westondunn/elegoo-smart-car-v4/hardware/3d-models/rover-v3/verification/component_catalog.csv

part_id | name | quantity | category | material_intent | geometry_fidelity | step_file | notes
base | Full lower chassis | 1 | printed_part | PLA | Exact generated printable CAD. Full assembly has not been physically tested. | assets/printed/base.step | Exact C3 local motor interfaces; actual OEM front/rear spacing; widened230mm body; four strap slots for vertical powerbank retention. Print motor-contact face down.
upper_deck | Upper service deck with battery slider | 1 | printed_part | PLA | Exact generated printable CAD. Full assembly has not been physically tested. | assets/printed/upper_deck.step | 168x210mm deck; battery pocket integrated on underside; source front-head interface. Print top surface down.
bank_rail_right | Powerbank retaining rail right | 1 | printed_part | PLA | Exact generated printable CAD. Full assembly has not been physically tested. | assets/printed/bank_rail_right.step
bank_rail_left | Powerbank retaining rail left | 1 | printed_part | PLA | Exact generated printable CAD. Full assembly has not been physically tested. | assets/printed/bank_rail_left.step
support_post_01 | Deck support post 1 | 1 | printed_part | PLA | Exact generated printable CAD. Full assembly has not been physically tested. | assets/printed/support_post_01.step
support_post_02 | Deck support post 2 | 1 | printed_part | PLA | Exact generated printable CAD. Full assembly has not been physically tested. | assets/printed/support_post_02.step
support_post_03 | Deck support post 3 | 1 | printed_part | PLA | Exact generated printable CAD. Full assembly has not been physically tested. | assets/printed/support_post_03.step
support_post_04 | Deck support post 4 | 1 | printed_part | PLA | Exact generated printable CAD. Full assembly has not been physically tested. | assets/printed/support_post_04.step
support_post_05 | Deck support post 5 | 1 | printed_part | PLA | Exact generated printable CAD. Full assembly has not been physically tested. | assets/printed/support_post_05.step
support_post_06 | Deck support post 6 | 1 | printed_part | PLA | Exact generated printable CAD. Full assembly has not been physically tested. | assets/printed/support_post_06.step
pi_standoff_01 | Pi board standoff 1 | 1 | printed_part | PLA | Exact generated printable CAD. Full assembly has not been physically tested. | assets/printed/pi_standoff_01.step
pi_standoff_02 | Pi board standoff 2 | 1 | printed_part | PLA | Exact generated printable CAD. Full assembly has not been physically tested. | assets/printed/pi_standoff_02.step
pi_standoff_03 | Pi board standoff 3 | 1 | printed_part | PLA | Exact generated printable CAD. Full assembly has not been physically tested. | assets/printed/pi_standoff_03.step
pi_standoff_04 | Pi board standoff 4 | 1 | printed_part | PLA | Exact generated printable CAD. Full assembly has not been physically tested. | assets/printed/pi_standoff_04.step
uno_standoff_01 | UNO board standoff 1 | 1 | printed_part | PLA | Exact generated printable CAD. Full assembly has not been physically tested. | assets/printed/uno_standoff_01.step
uno_standoff_02 | UNO board standoff 2 | 1 | printed_part | PLA | Exact generated printable CAD. Full assembly has not been physically tested. | assets/printed/uno_standoff_02.step
uno_standoff_03 | UNO board standoff 3 | 1 | printed_part | PLA | Exact generated printable CAD. Full assembly has not been physically tested. | assets/printed/uno_standoff_03.step
tracker_spacer_01 | Line tracker spacer 1 | 1 | printed_part | PLA | Exact generated printable CAD. Full assembly has not been physically tested. | assets/printed/tracker_spacer_01.step
tracker_spacer_02 | Line tracker spacer 2 | 1 | printed_part | PLA | Exact generated printable CAD. Full assembly has not been physically tested. | assets/printed/tracker_spacer_02.step
tracker_spacer_03 | Line tracker spacer 3 | 1 | printed_part | PLA | Exact generated printable CAD. Full assembly has not been physically tested. | assets/printed/tracker_spacer_03.step
tracker_spacer_04 | Line tracker spacer 4 | 1 | printed_part | PLA | Exact generated printable CAD. Full assembly has not been physically tested. | assets/printed/tracker_spacer_04.step
motor_battery | Motor battery - nominal case | 1 | battery | Composite/reference or unspecified | Nominal 86 x 52 x 22; not a measured case model | assets/hardware/motor_battery.step | 76 mm nominal mount pitch, adjustable printed range65–90 mm. Rear orientation is preferred; check actual plug engagement before tightening.
motor_battery_switch | Motor battery - rear switch reference | 1 | electronics | Composite/reference or unspecified | Approximate location and shape | assets/hardware/motor_battery_switch.step | Switch location conveys rear orientation only.
uno_board | ELEGOO Uno format board - PCB reference | 1 | electronics | Composite/reference or unspecified | Mounting pattern sourced; PCB outline nominal | assets/hardware/uno_board.step | Three-hole mount comes from the original OEM top plate; 68.6 x53.4 outer rectangle is a simplified reference.
uno_board_connectors | ELEGOO Uno format board - connector envelopes | 1 | electronics | Composite/reference or unspecified | Approximate connector envelopes | assets/hardware/uno_board_connectors.step | Connector locations are representative. Actual board revision is unconfirmed; existing cables remain authoritative.
motor_shield | ELEGOO motor shield - reference envelope | 1 | electronics | Composite/reference or unspecified | Nominal stacked board envelope | assets/hardware/motor_shield.step | Actual shield revision not identified. OEM2020 DRV8835 schematic and New repository firmware are separate references.
shield_connectors | Motor shield - plug envelopes | 1 | electronics | Composite/reference or unspecified | Approximate | assets/hardware/shield_connectors.step | Existing plugs and routing remain authoritative.
block_front_left | Silver motor block - front_left | 1 | hardware | Aluminum | User outer22 x12 x4; OEM/C1 hole pattern | assets/hardware/block_front_left.step | Block orientation/height in assembly is nominal; the base interface comes from the physically successful C1/C3 geometry.
motor_front_left | TT motor gearbox reference - front_left | 1 | motor | Composite/reference or unspecified | Nominal TT envelope; shaft axis approximate | assets/hardware/motor_front_left.step | Axis is a motion demonstration only. OEM archive does not include motor geometry. Keep the stock motor and silver block assembly intact.
motor_can_front_left | Motor can reference - front_left | 1 | hardware | Steel | Nominal 70 mm total TT body length | assets/hardware/motor_can_front_left.step | Representative motor can envelope.
wheel_hub_front_left | Wheel hub reference - front_left | 1 | wheel | Composite/reference or unspecified | Nominal wheel envelope | assets/hardware/wheel_hub_front_left.step | Wheel model is illustrative; local motor-to-wheel clearance remains based on the successful physical fit, not this nominal solid.
tire_front_left | Tire reference - front_left | 1 | wheel | Rubber | Nominal 65 mm diameter x26 mm width | assets/hardware/tire_front_left.step | No claim of measured diameter, traction or clearance sweep.
shaft_front_left | Output shaft reference - front_left | 1 | hardware | Composite/reference or unspecified | Approximate shaft envelope | assets/hardware/shaft_front_left.step | Shaft projection not reverse engineered; rotation is kinematic only.
block_front_right | Silver motor block - front_right | 1 | hardware | Aluminum | User outer22 x12 x4; OEM/C1 hole pattern | assets/hardware/block_front_right.step | Block orientation/height in assembly is nominal; the base interface comes from the physically successful C1/C3 geometry.
motor_front_right | TT motor gearbox reference - front_right | 1 | motor | Composite/reference or unspecified | Nominal TT envelope; shaft axis approximate | assets/hardware/motor_front_right.step | Axis is a motion demonstration only. OEM archive does not include motor geometry. Keep the stock motor and silver block assembly intact.
motor_can_front_right | Motor can reference - front_right | 1 | hardware | Steel | Nominal 70 mm total TT body length | assets/hardware/motor_can_front_right.step | Representative motor can envelope.
wheel_hub_front_right | Wheel hub reference - front_right | 1 | wheel | Composite/reference or unspecified | Nominal wheel envelope | assets/hardware/wheel_hub_front_right.step | Wheel model is illustrative; local motor-to-wheel clearance remains based on the successful physical fit, not this nominal solid.
tire_front_right | Tire reference - front_right | 1 | wheel | Rubber | Nominal 65 mm diameter x26 mm width | assets/hardware/tire_front_right.step | No claim of measured diameter, traction or clearance sweep.
shaft_front_right | Output shaft reference - front_right | 1 | hardware | Composite/reference or unspecified | Approximate shaft envelope | assets/hardware/shaft_front_right.step | Shaft projection not reverse engineered; rotation is kinematic only.
block_rear_left | Silver motor block - rear_left | 1 | hardware | Aluminum | User outer22 x12 x4; OEM/C1 hole pattern | assets/hardware/block_rear_left.step | Block orientation/height in assembly is nominal; the base interface comes from the physically successful C1/C3 geometry.
motor_rear_left | TT motor gearbox reference - rear_left | 1 | motor | Composite/reference or unspecified | Nominal TT envelope; shaft axis approximate | assets/hardware/motor_rear_left.step | Axis is a motion demonstration only. OEM archive does not include motor geometry. Keep the stock motor and silver block assembly intact.
motor_can_rear_left | Motor can reference - rear_left | 1 | hardware | Steel | Nominal 70 mm total TT body length | assets/hardware/motor_can_rear_left.step | Representative motor can envelope.
wheel_hub_rear_left | Wheel hub reference - rear_left | 1 | wheel | Composite/reference or unspecified | Nominal wheel envelope | assets/hardware/wheel_hub_rear_left.step | Wheel model is illustrative; local motor-to-wheel clearance remains based on the successful physical fit, not this nominal solid.
tire_rear_left | Tire reference - rear_left | 1 | wheel | Rubber | Nominal 65 mm diameter x26 mm width | assets/hardware/tire_rear_left.step | No claim of measured diameter, traction or clearance sweep.
shaft_rear_left | Output shaft reference - rear_left | 1 | hardware | Composite/reference or unspecified | Approximate shaft envelope | assets/hardware/shaft_rear_left.step | Shaft projection not reverse engineered; rotation is kinematic only.
block_rear_right | Silver motor block - rear_right | 1 | hardware | Aluminum | User outer22 x12 x4; OEM/C1 hole pattern | assets/hardware/block_rear_right.step | Block orientation/height in assembly is nominal; the base interface comes from the physically successful C1/C3 geometry.
motor_rear_right | TT motor gearbox reference - rear_right | 1 | motor | Composite/reference or unspecified | Nominal TT envelope; shaft axis approximate | assets/hardware/motor_rear_right.step | Axis is a motion demonstration only. OEM archive does not include motor geometry. Keep the stock motor and silver block assembly intact.
motor_can_rear_right | Motor can reference - rear_right | 1 | hardware | Steel | Nominal 70 mm total TT body length | assets/hardware/motor_can_rear_right.step | Representative motor can envelope.
wheel_hub_rear_right | Wheel hub reference - rear_right | 1 | wheel | Composite/reference or unspecified | Nominal wheel envelope | assets/hardware/wheel_hub_rear_right.step | Wheel model is illustrative; local motor-to-wheel clearance remains based on the successful physical fit, not this nominal solid.
tire_rear_right | Tire reference - rear_right | 1 | wheel | Rubber | Nominal 65 mm diameter x26 mm width | assets/hardware/tire_rear_right.step | No claim of measured diameter, traction or clearance sweep.
shaft_rear_right | Output shaft reference - rear_right | 1 | hardware | Composite/reference or unspecified | Approximate shaft envelope | assets/hardware/shaft_rear_right.step | Shaft projection not reverse engineered; rotation is kinematic only.
pan_servo | Stock pan servo - reference | 1 | electronics | Composite/reference or unspecified | Approximate SG90-type envelope | assets/hardware/pan_servo.step | Head support uses source OEM front interface; original bracket/horn are reused.
servo_horn | Stock servo horn - reference | 1 | hardware | Composite/reference or unspecified | Approximate | assets/hardware/servo_horn.step | Do not use this reference model to print a replacement horn.
sensor_head | Original head bracket - reference | 1 | hardware | Composite/reference or unspecified | Approximate | assets/hardware/sensor_head.step | Retain the original complete camera/sonar bracket assembly.
ultrasonic_board | Ultrasonic sensor - reference | 1 | electronics | Composite/reference or unspecified | Approximate 45 x20 board | assets/hardware/ultrasonic_board.step | Original sensor and bracket retained; no inferred mounting-hole or electrical pinout.
sonar_transducers | Ultrasonic transducers - reference | 1 | electronics | Composite/reference or unspecified | Approximate | assets/hardware/sonar_transducers.step | Representative sensing head, not acoustic or electrical simulation.
camera_board | ESP32/camera head - reference | 1 | electronics | Composite/reference or unspecified | Approximate envelope | assets/hardware/camera_board.step | Exact camera board and orientation unconfirmed. Original assembly is reused.
camera_lens | Camera lens - reference | 1 | electronics | Composite/reference or unspecified | Approximate | assets/hardware/camera_lens.step | Display reference only.
line_tracker | Original line tracker - reference | 1 | electronics | Composite/reference or unspecified | Original OEM lower-plate mounting pattern | assets/hardware/line_tracker.step | Sensor height is a provisional assembly position; adjust using the removable spacers and actual wheel/ground geometry.
tracker_sensors | Line sensors - reference | 1 | electronics | Composite/reference or unspecified | Approximate | assets/hardware/tracker_sensors.step | Actual road gap must be checked at assembly.
