westondunn/elegoo-smart-car-v4/hardware/3d-models/rover-v3/verification/fusion_feature_map.csv

part_id | name | intended_build_method | native_dimensions | runtime_status
base | Full lower chassis | Imported solid STEP BRep | No recovered source feature history | Desktop Fusion not run; inspect its generated report for actual result
upper_deck | Upper service deck with battery slider | Imported solid STEP BRep | No recovered source feature history | Desktop Fusion not run; inspect its generated report for actual result
bank_rail_right | Powerbank retaining rail right | Imported solid STEP BRep | No recovered source feature history | Desktop Fusion not run; inspect its generated report for actual result
bank_rail_left | Powerbank retaining rail left | Imported solid STEP BRep | No recovered source feature history | Desktop Fusion not run; inspect its generated report for actual result
support_post_01 | Deck support post 1 | Native circular sketch, extrusion, bore sketch and cut | Base Z, group outside diameter, group height, group bore diameter | Desktop Fusion not run; inspect its generated report for actual result
support_post_02 | Deck support post 2 | Native circular sketch, extrusion, bore sketch and cut | Base Z, group outside diameter, group height, group bore diameter | Desktop Fusion not run; inspect its generated report for actual result
support_post_03 | Deck support post 3 | Native circular sketch, extrusion, bore sketch and cut | Base Z, group outside diameter, group height, group bore diameter | Desktop Fusion not run; inspect its generated report for actual result
support_post_04 | Deck support post 4 | Native circular sketch, extrusion, bore sketch and cut | Base Z, group outside diameter, group height, group bore diameter | Desktop Fusion not run; inspect its generated report for actual result
support_post_05 | Deck support post 5 | Native circular sketch, extrusion, bore sketch and cut | Base Z, group outside diameter, group height, group bore diameter | Desktop Fusion not run; inspect its generated report for actual result
support_post_06 | Deck support post 6 | Native circular sketch, extrusion, bore sketch and cut | Base Z, group outside diameter, group height, group bore diameter | Desktop Fusion not run; inspect its generated report for actual result
pi_standoff_01 | Pi board standoff 1 | Native circular sketch, extrusion, bore sketch and cut | Base Z, group outside diameter, group height, group bore diameter | Desktop Fusion not run; inspect its generated report for actual result
pi_standoff_02 | Pi board standoff 2 | Native circular sketch, extrusion, bore sketch and cut | Base Z, group outside diameter, group height, group bore diameter | Desktop Fusion not run; inspect its generated report for actual result
pi_standoff_03 | Pi board standoff 3 | Native circular sketch, extrusion, bore sketch and cut | Base Z, group outside diameter, group height, group bore diameter | Desktop Fusion not run; inspect its generated report for actual result
pi_standoff_04 | Pi board standoff 4 | Native circular sketch, extrusion, bore sketch and cut | Base Z, group outside diameter, group height, group bore diameter | Desktop Fusion not run; inspect its generated report for actual result
uno_standoff_01 | UNO board standoff 1 | Native circular sketch, extrusion, bore sketch and cut | Base Z, group outside diameter, group height, group bore diameter | Desktop Fusion not run; inspect its generated report for actual result
uno_standoff_02 | UNO board standoff 2 | Native circular sketch, extrusion, bore sketch and cut | Base Z, group outside diameter, group height, group bore diameter | Desktop Fusion not run; inspect its generated report for actual result
uno_standoff_03 | UNO board standoff 3 | Native circular sketch, extrusion, bore sketch and cut | Base Z, group outside diameter, group height, group bore diameter | Desktop Fusion not run; inspect its generated report for actual result
tracker_spacer_01 | Line tracker spacer 1 | Native circular sketch, extrusion, bore sketch and cut | Base Z, group outside diameter, group height, group bore diameter | Desktop Fusion not run; inspect its generated report for actual result
tracker_spacer_02 | Line tracker spacer 2 | Native circular sketch, extrusion, bore sketch and cut | Base Z, group outside diameter, group height, group bore diameter | Desktop Fusion not run; inspect its generated report for actual result
tracker_spacer_03 | Line tracker spacer 3 | Native circular sketch, extrusion, bore sketch and cut | Base Z, group outside diameter, group height, group bore diameter | Desktop Fusion not run; inspect its generated report for actual result
tracker_spacer_04 | Line tracker spacer 4 | Native circular sketch, extrusion, bore sketch and cut | Base Z, group outside diameter, group height, group bore diameter | Desktop Fusion not run; inspect its generated report for actual result
motor_battery | Motor battery - nominal case | Imported solid STEP BRep | No recovered source feature history | Desktop Fusion not run; inspect its generated report for actual result
motor_battery_switch | Motor battery - rear switch reference | Imported solid STEP BRep | No recovered source feature history | Desktop Fusion not run; inspect its generated report for actual result
uno_board | ELEGOO Uno format board - PCB reference | Imported solid STEP BRep | No recovered source feature history | Desktop Fusion not run; inspect its generated report for actual result
uno_board_connectors | ELEGOO Uno format board - connector envelopes | Imported solid STEP BRep | No recovered source feature history | Desktop Fusion not run; inspect its generated report for actual result
motor_shield | ELEGOO motor shield - reference envelope | Imported solid STEP BRep | No recovered source feature history | Desktop Fusion not run; inspect its generated report for actual result
shield_connectors | Motor shield - plug envelopes | Imported solid STEP BRep | No recovered source feature history | Desktop Fusion not run; inspect its generated report for actual result
block_front_left | Silver motor block - front_left | Imported solid STEP BRep | No recovered source feature history | Desktop Fusion not run; inspect its generated report for actual result
motor_front_left | TT motor gearbox reference - front_left | Imported solid STEP BRep | No recovered source feature history | Desktop Fusion not run; inspect its generated report for actual result
motor_can_front_left | Motor can reference - front_left | Imported solid STEP BRep | No recovered source feature history | Desktop Fusion not run; inspect its generated report for actual result
wheel_hub_front_left | Wheel hub reference - front_left | Imported solid STEP BRep | No recovered source feature history | Desktop Fusion not run; inspect its generated report for actual result
tire_front_left | Tire reference - front_left | Imported solid STEP BRep | No recovered source feature history | Desktop Fusion not run; inspect its generated report for actual result
shaft_front_left | Output shaft reference - front_left | Imported solid STEP BRep | No recovered source feature history | Desktop Fusion not run; inspect its generated report for actual result
block_front_right | Silver motor block - front_right | Imported solid STEP BRep | No recovered source feature history | Desktop Fusion not run; inspect its generated report for actual result
motor_front_right | TT motor gearbox reference - front_right | Imported solid STEP BRep | No recovered source feature history | Desktop Fusion not run; inspect its generated report for actual result
motor_can_front_right | Motor can reference - front_right | Imported solid STEP BRep | No recovered source feature history | Desktop Fusion not run; inspect its generated report for actual result
wheel_hub_front_right | Wheel hub reference - front_right | Imported solid STEP BRep | No recovered source feature history | Desktop Fusion not run; inspect its generated report for actual result
tire_front_right | Tire reference - front_right | Imported solid STEP BRep | No recovered source feature history | Desktop Fusion not run; inspect its generated report for actual result
shaft_front_right | Output shaft reference - front_right | Imported solid STEP BRep | No recovered source feature history | Desktop Fusion not run; inspect its generated report for actual result
block_rear_left | Silver motor block - rear_left | Imported solid STEP BRep | No recovered source feature history | Desktop Fusion not run; inspect its generated report for actual result
motor_rear_left | TT motor gearbox reference - rear_left | Imported solid STEP BRep | No recovered source feature history | Desktop Fusion not run; inspect its generated report for actual result
motor_can_rear_left | Motor can reference - rear_left | Imported solid STEP BRep | No recovered source feature history | Desktop Fusion not run; inspect its generated report for actual result
wheel_hub_rear_left | Wheel hub reference - rear_left | Imported solid STEP BRep | No recovered source feature history | Desktop Fusion not run; inspect its generated report for actual result
tire_rear_left | Tire reference - rear_left | Imported solid STEP BRep | No recovered source feature history | Desktop Fusion not run; inspect its generated report for actual result
shaft_rear_left | Output shaft reference - rear_left | Imported solid STEP BRep | No recovered source feature history | Desktop Fusion not run; inspect its generated report for actual result
block_rear_right | Silver motor block - rear_right | Imported solid STEP BRep | No recovered source feature history | Desktop Fusion not run; inspect its generated report for actual result
motor_rear_right | TT motor gearbox reference - rear_right | Imported solid STEP BRep | No recovered source feature history | Desktop Fusion not run; inspect its generated report for actual result
motor_can_rear_right | Motor can reference - rear_right | Imported solid STEP BRep | No recovered source feature history | Desktop Fusion not run; inspect its generated report for actual result
wheel_hub_rear_right | Wheel hub reference - rear_right | Imported solid STEP BRep | No recovered source feature history | Desktop Fusion not run; inspect its generated report for actual result
tire_rear_right | Tire reference - rear_right | Imported solid STEP BRep | No recovered source feature history | Desktop Fusion not run; inspect its generated report for actual result
shaft_rear_right | Output shaft reference - rear_right | Imported solid STEP BRep | No recovered source feature history | Desktop Fusion not run; inspect its generated report for actual result
pan_servo | Stock pan servo - reference | Imported solid STEP BRep | No recovered source feature history | Desktop Fusion not run; inspect its generated report for actual result
servo_horn | Stock servo horn - reference | Imported solid STEP BRep | No recovered source feature history | Desktop Fusion not run; inspect its generated report for actual result
sensor_head | Original head bracket - reference | Imported solid STEP BRep | No recovered source feature history | Desktop Fusion not run; inspect its generated report for actual result
ultrasonic_board | Ultrasonic sensor - reference | Imported solid STEP BRep | No recovered source feature history | Desktop Fusion not run; inspect its generated report for actual result
sonar_transducers | Ultrasonic transducers - reference | Imported solid STEP BRep | No recovered source feature history | Desktop Fusion not run; inspect its generated report for actual result
camera_board | ESP32/camera head - reference | Imported solid STEP BRep | No recovered source feature history | Desktop Fusion not run; inspect its generated report for actual result
camera_lens | Camera lens - reference | Imported solid STEP BRep | No recovered source feature history | Desktop Fusion not run; inspect its generated report for actual result
line_tracker | Original line tracker - reference | Imported solid STEP BRep | No recovered source feature history | Desktop Fusion not run; inspect its generated report for actual result
tracker_sensors | Line sensors - reference | Imported solid STEP BRep | No recovered source feature history | Desktop Fusion not run; inspect its generated report for actual result
