westondunn/elegoo-smart-car-v4/hardware/3d-models/rover-v3/cad/complete_assembly.step

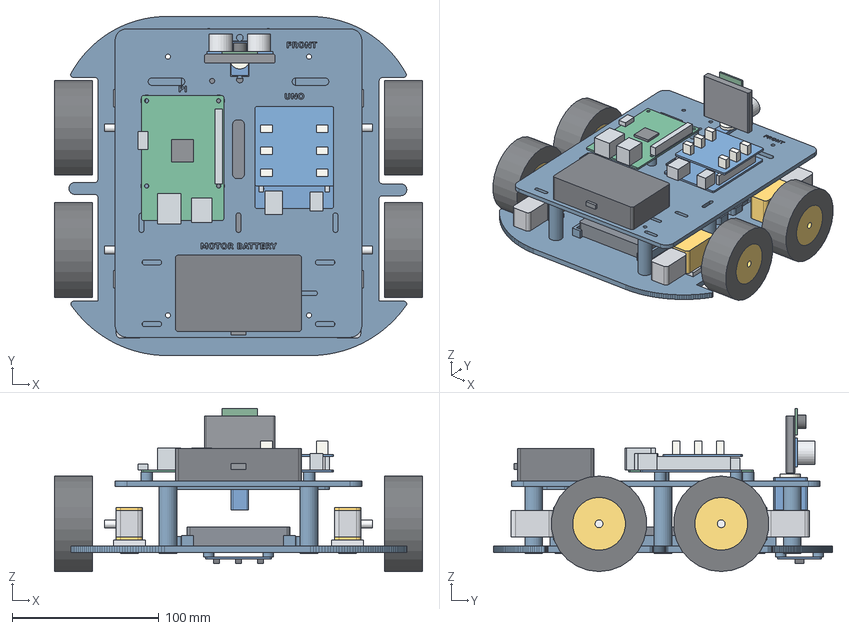
[picture p1: CAD file, 2026-10-30]
hardware/3d-models/rover-v3/cad/complete_assembly.step
250.5 x 230.8 x 111.0 mm
base
upper_deck
bank_rail_right
bank_rail_left
support_post_01
support_post_02
support_post_03
support_post_04
support_post_05
support_post_06
pi_standoff_01
pi_standoff_02
pi_standoff_03
pi_standoff_04
uno_standoff_01
uno_standoff_02
uno_standoff_03
tracker_spacer_01
tracker_spacer_02
tracker_spacer_03
tracker_spacer_04
power_bank
motor_battery
motor_battery_switch
pi_board
pi_board_connectors
pi_processor
uno_board
uno_board_connectors
motor_shield
shield_connectors
block_front_left
motor_front_left
motor_can_front_left
wheel_hub_front_left
tire_front_left
shaft_front_left
block_front_right
motor_front_right
motor_can_front_right
wheel_hub_front_right
tire_front_right
shaft_front_right
block_rear_left
motor_rear_left
motor_can_rear_left
wheel_hub_rear_left
tire_rear_left
shaft_rear_left
block_rear_right
motor_rear_right
motor_can_rear_right
wheel_hub_rear_right
tire_rear_right
shaft_rear_right
pan_servo
servo_horn
sensor_head
ultrasonic_board
sonar_transducers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
