westondunn/elegoo-smart-car-v4/hardware/3d-models/rover-v3/print/full_rover_x1c_pla.3mf

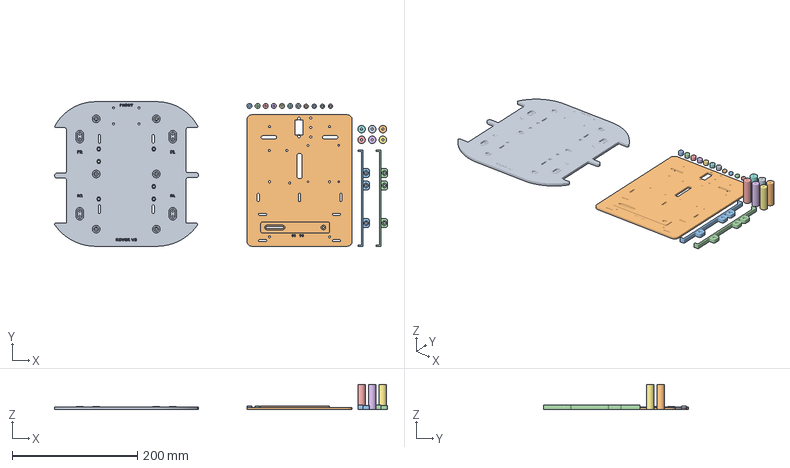
[picture p2: CAD file, 2026-10-30]
hardware/3d-models/rover-v3/print/full_rover_x1c_pla.3mf
531.6 x 230.8 x 40.5 mm
01 FULL LOWER CHASSIS_1
02 UPPER SERVICE DECK_1
03 POWER BANK RAIL A_1
04 POWER BANK RAIL B_1
05 DECK POST 1_1
06 DECK POST 2_1
07 DECK POST 3_1
08 DECK POST 4_1
09 DECK POST 5_1
10 DECK POST 6_1
11 PI STANDOFF 1_1
12 PI STANDOFF 2_1
13 PI STANDOFF 3_1
14 PI STANDOFF 4_1
15 UNO STANDOFF 1_1
16 UNO STANDOFF 2_1
17 UNO STANDOFF 3_1
18 TRACKER SPACER 1_1
19 TRACKER SPACER 2_1
20 TRACKER SPACER 3_1
21 TRACKER SPACER 4_1
