westondunn/elegoo-smart-car-v4/hardware/3d-models/rover-v3/cad/coupons/c1_motor_fit.step

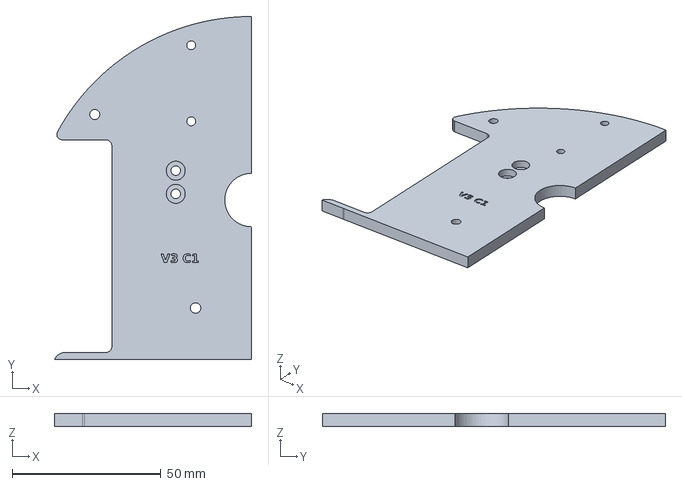
[picture p3: CAD file, 2026-10-30]
hardware/3d-models/rover-v3/cad/coupons/c1_motor_fit.step
66.3 x 115.4 x 4.50 mm
