westondunn/elegoo-smart-car-v4/hardware/3d-models/rover-v3/fusion/RoverFusion/assets/hardware/wheel_hub_rear_left.step

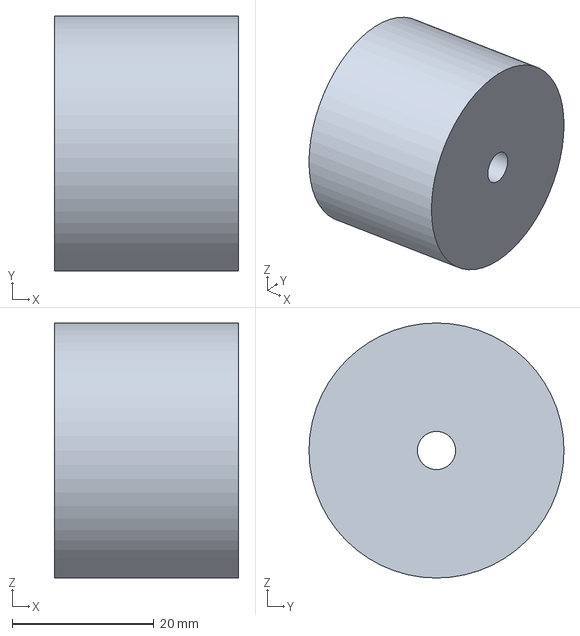
[picture p4: CAD file, 2026-10-30]
hardware/3d-models/rover-v3/fusion/RoverFusion/assets/hardware/wheel_hub_rear_left.step
26.0 x 36.0 x 36.0 mm
