westondunn/elegoo-smart-car-v4/hardware/3d-models/rover-v3/fusion/RoverFusion/assets/printed/base.step

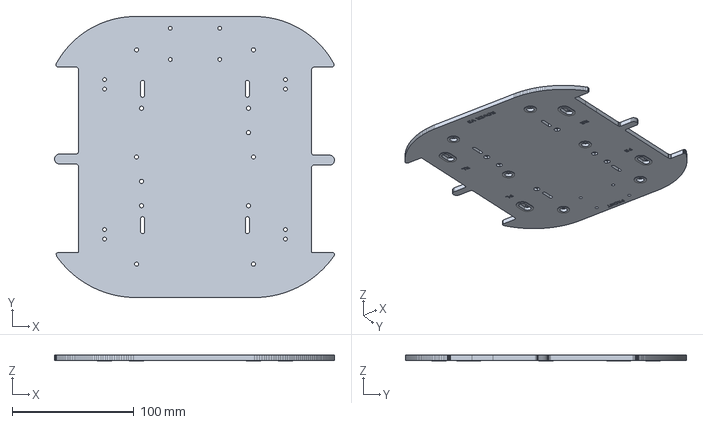
[picture p5: CAD file, 2026-10-30]
hardware/3d-models/rover-v3/fusion/RoverFusion/assets/printed/base.step
230.0 x 230.8 x 5.10 mm
