westondunn/elegoo-smart-car-v4/hardware/3d-models/rover-v3/print/fit_checks/c3_motor_corner_and_battery_rail_x1c_pla.3mf

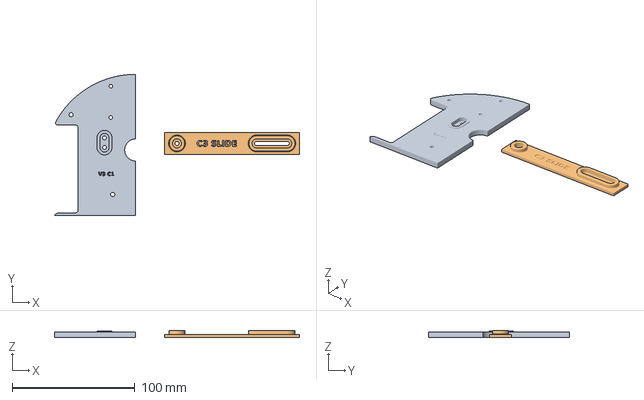
[picture p6: CAD file, 2026-10-30]
hardware/3d-models/rover-v3/print/fit_checks/c3_motor_corner_and_battery_rail_x1c_pla.3mf
200.0 x 115.4 x 5.70 mm
C3 MOTOR CORNER FROM C1_1
C3 BATTERY RECESSED RAIL_1
