westondunn/elegoo-smart-car-v4/hardware/3d-models/rover-v3/cad/coupons/c3_motor_fit_integrated.step

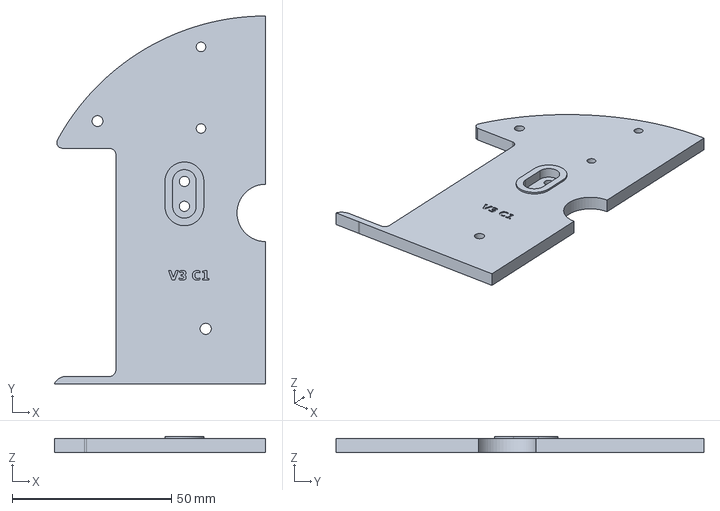
[picture p7: CAD file, 2026-10-30]
hardware/3d-models/rover-v3/cad/coupons/c3_motor_fit_integrated.step
66.3 x 115.4 x 5.10 mm
