westondunn/elegoo-smart-car-v4/hardware/3d-models/rover-v3/fusion/RoverFusion/assets/hardware/camera_board.step

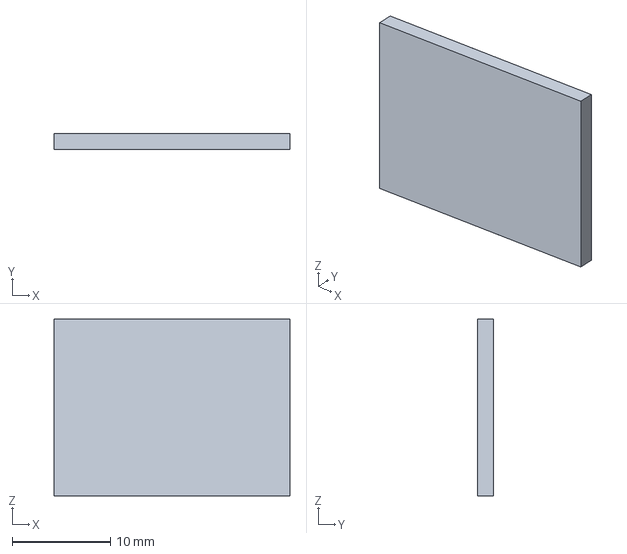
[picture p8: CAD file, 2026-10-30]
hardware/3d-models/rover-v3/fusion/RoverFusion/assets/hardware/camera_board.step
24.0 x 1.60 x 18.0 mm
