westondunn/elegoo-smart-car-v4/hardware/3d-models/rover-v3/fusion/RoverFusion/assets/printed/bank_rail_left.step

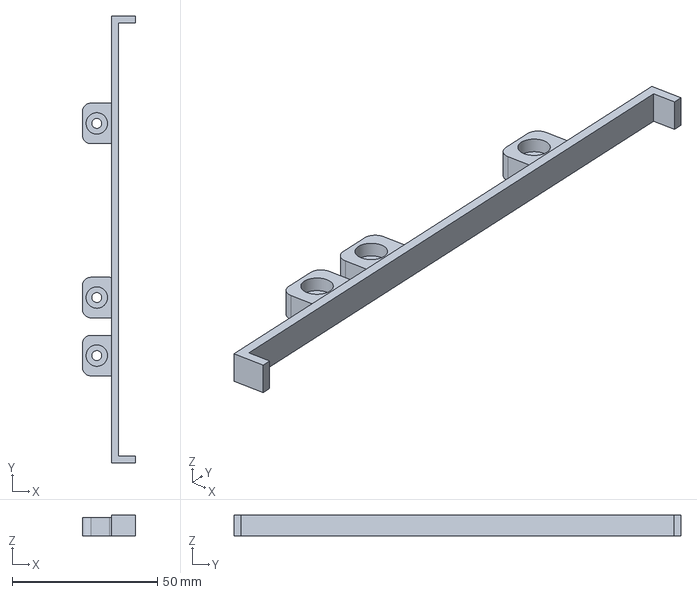
[picture p9: CAD file, 2026-10-30]
hardware/3d-models/rover-v3/fusion/RoverFusion/assets/printed/bank_rail_left.step
18.4 x 154.0 x 7.20 mm
