westondunn/elegoo-smart-car-v4/hardware/3d-models/rover-v3/print/fit_checks/fit_batch_x1c_pla.3mf

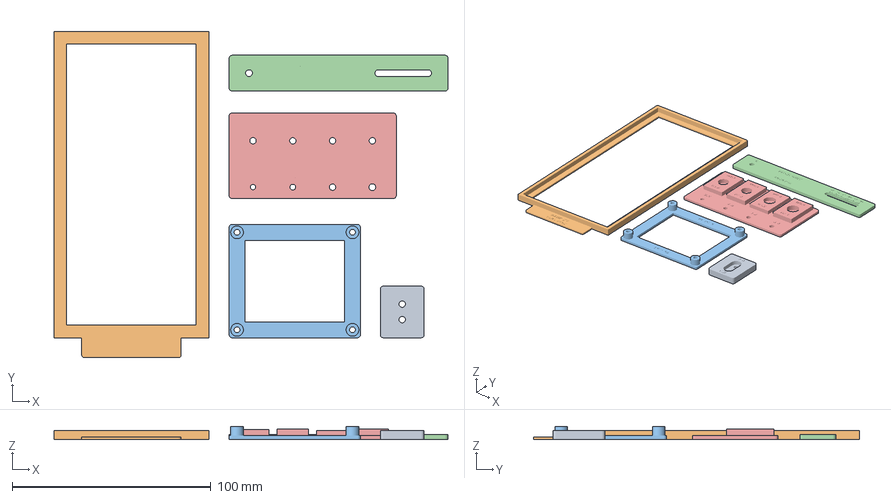
[picture p10: CAD file, 2026-10-30]
hardware/3d-models/rover-v3/print/fit_checks/fit_batch_x1c_pla.3mf
198.0 x 164.0 x 6.30 mm
01_C2_Washer_Gauge
02_Flat_Battery_XY_Frame
05_Hardware_Selector
04_Motor_Battery_Pitch
03_Pi_58x49_Pattern
