westondunn/elegoo-smart-car-v4/hardware/3d-models/rover-v3/fusion/RoverFusion/assets/hardware/pan_servo.step

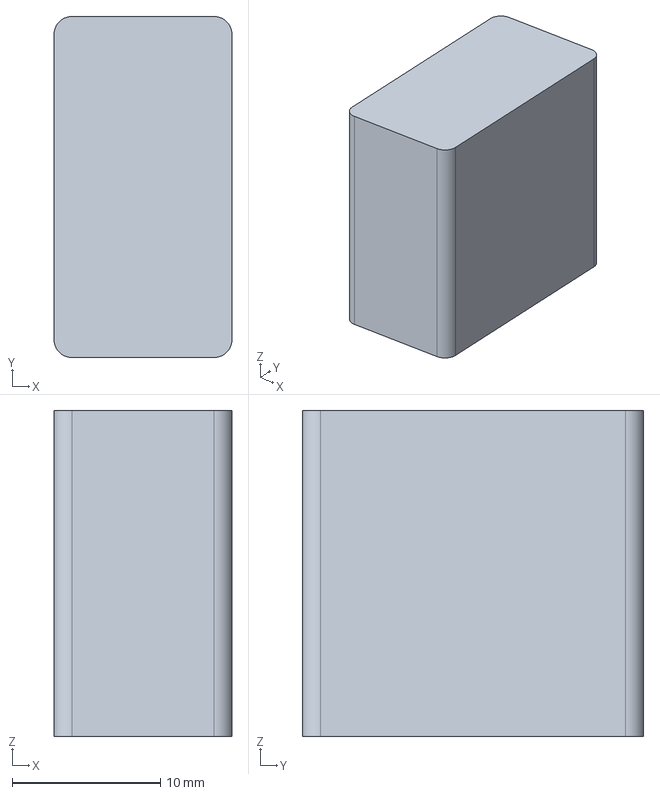
[picture p11: CAD file, 2026-10-30]
hardware/3d-models/rover-v3/fusion/RoverFusion/assets/hardware/pan_servo.step
12.0 x 23.0 x 22.0 mm
