westondunn/elegoo-smart-car-v4/hardware/3d-models/rover-v3/fusion/RoverFusion/assets/hardware/motor_battery_switch.step

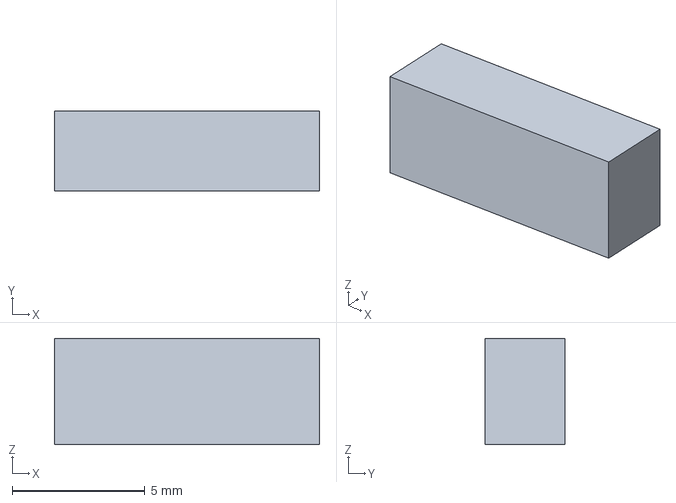
[picture p14: CAD file, 2026-10-30]
hardware/3d-models/rover-v3/fusion/RoverFusion/assets/hardware/motor_battery_switch.step
10.0 x 3.00 x 4.00 mm
