westondunn/elegoo-smart-car-v4/hardware/3d-models/rover-v3/fusion/RoverFusion/assets/printed/support_post_06.step

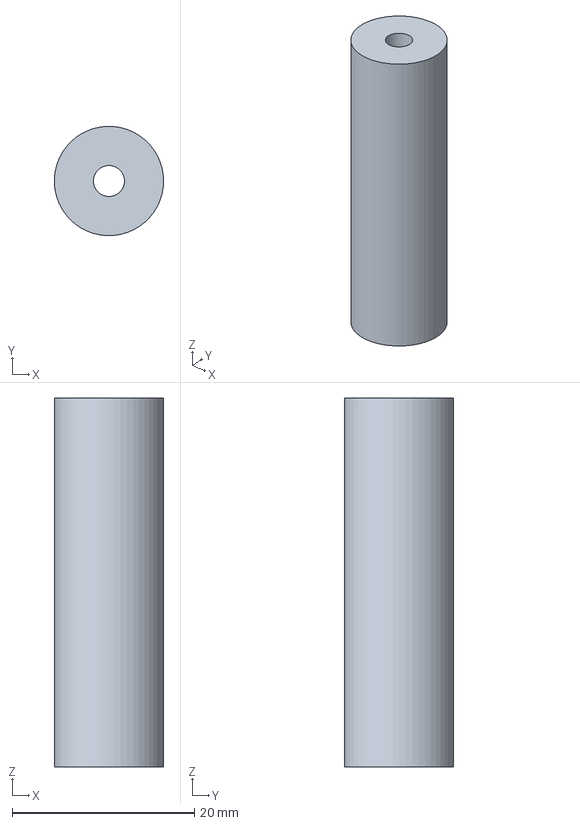
[picture p15: CAD file, 2026-10-30]
hardware/3d-models/rover-v3/fusion/RoverFusion/assets/printed/support_post_06.step
12.0 x 12.0 x 40.5 mm
