westondunn/elegoo-smart-car-v4/hardware/3d-models/rover-v3/fusion/RoverFusion/assets/hardware/shaft_front_right.step

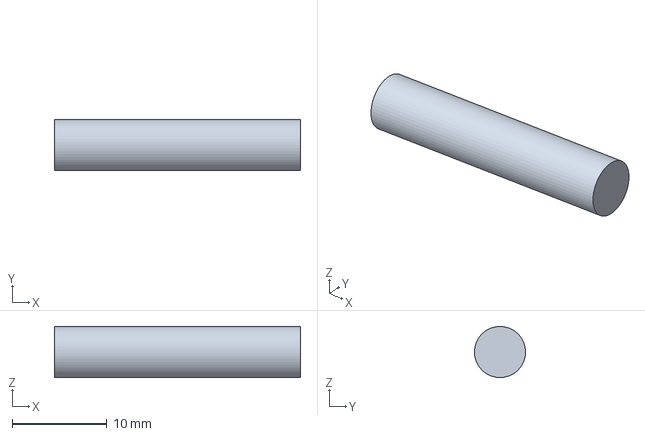
[picture p16: CAD file, 2026-10-30]
hardware/3d-models/rover-v3/fusion/RoverFusion/assets/hardware/shaft_front_right.step
26.0 x 5.40 x 5.39 mm
