westondunn/elegoo-smart-car-v4/hardware/3d-models/rover-v3/fusion/RoverFusion/assets/hardware/sonar_transducers.step

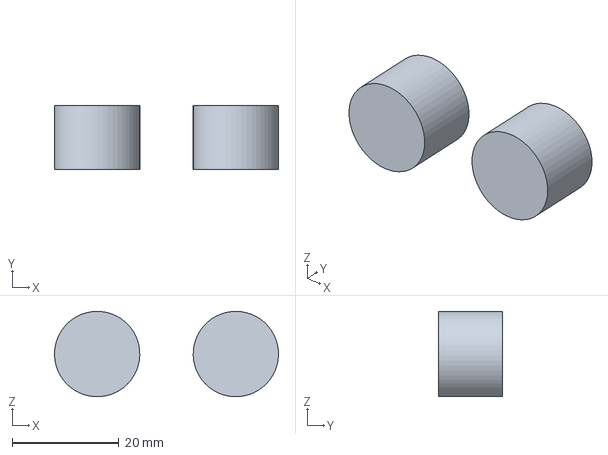
[picture p17: CAD file, 2026-10-30]
hardware/3d-models/rover-v3/fusion/RoverFusion/assets/hardware/sonar_transducers.step
42.0 x 12.0 x 16.0 mm
