westondunn/elegoo-smart-car-v4/hardware/3d-models/rover-v3/fusion/RoverFusion/assets/hardware/motor_rear_right.step

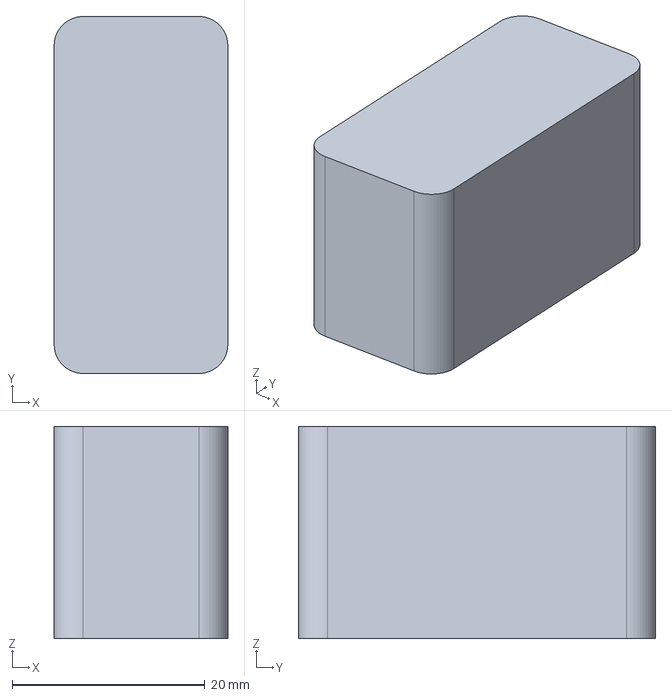
[picture p18: CAD file, 2026-10-30]
hardware/3d-models/rover-v3/fusion/RoverFusion/assets/hardware/motor_rear_right.step
18.0 x 37.0 x 22.0 mm
