westondunn/elegoo-smart-car-v4/hardware/3d-models/rover-v3/fusion/RoverFusion/assets/printed/tracker_spacer_01.step

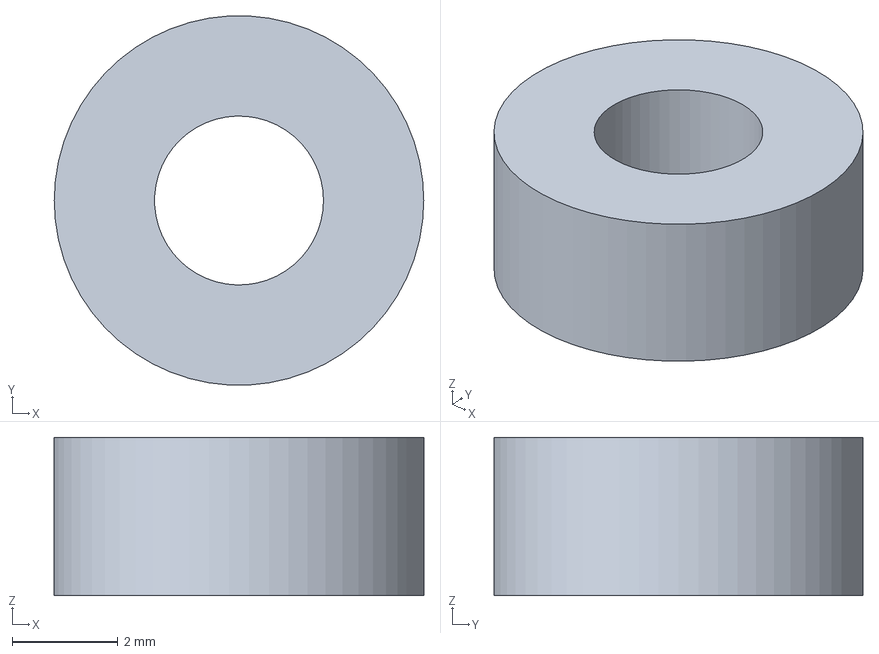
[picture p19: CAD file, 2026-10-30]
hardware/3d-models/rover-v3/fusion/RoverFusion/assets/printed/tracker_spacer_01.step
7.00 x 6.99 x 3.00 mm
