westondunn/elegoo-smart-car-v4/hardware/3d-models/rover-v3/fusion/RoverFusion/assets/hardware/uno_board_connectors.step

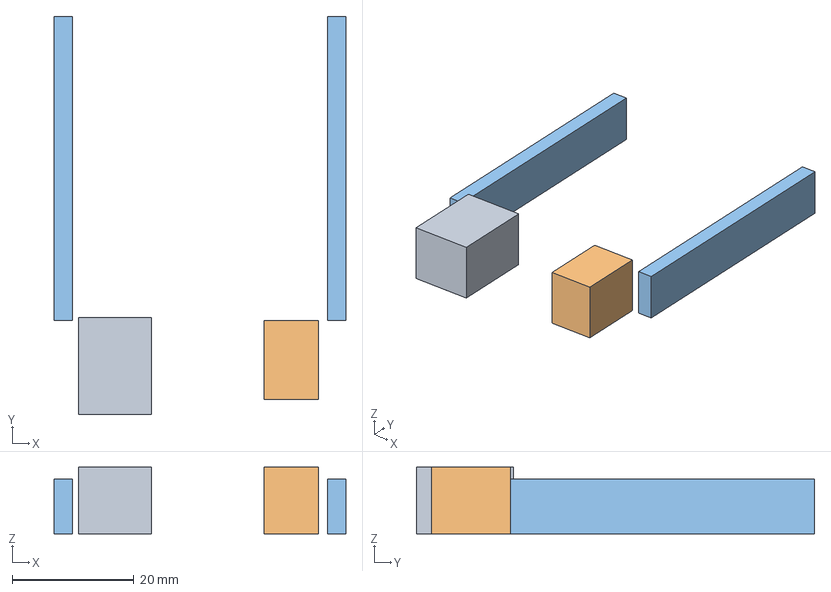
[picture p20: CAD file, 2026-10-30]
hardware/3d-models/rover-v3/fusion/RoverFusion/assets/hardware/uno_board_connectors.step
48.0 x 65.5 x 11.0 mm
