westondunn/elegoo-smart-car-v4/hardware/3d-models/rover-v3/fusion/RoverFusion/assets/hardware/block_rear_right.step

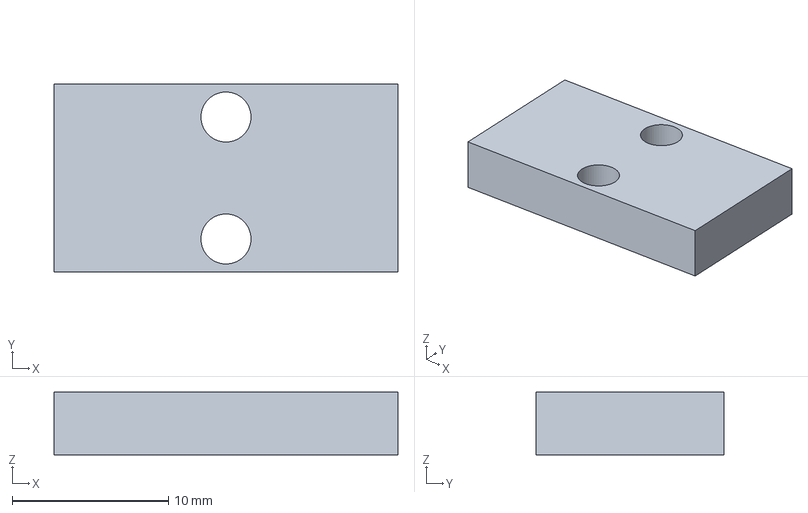
[picture p22: CAD file, 2026-10-30]
hardware/3d-models/rover-v3/fusion/RoverFusion/assets/hardware/block_rear_right.step
22.0 x 12.0 x 4.00 mm
