westondunn/elegoo-smart-car-v4/hardware/3d-models/rover-v3/fusion/RoverFusion/assets/hardware/tracker_sensors.step

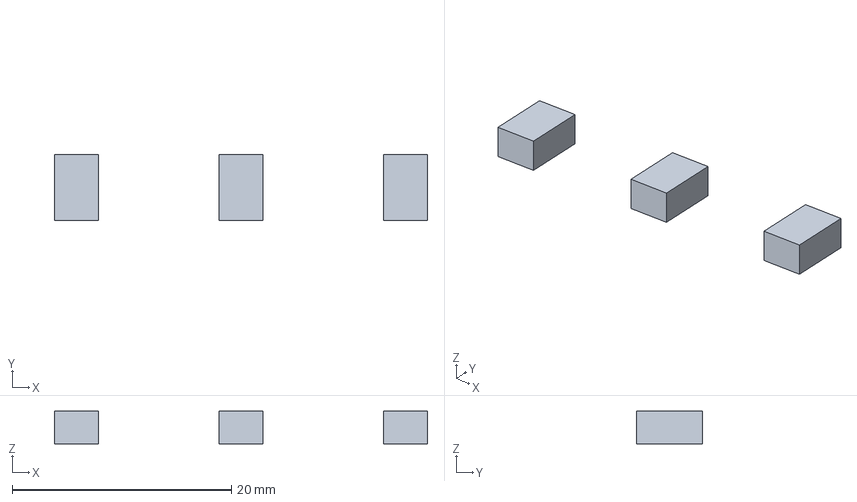
[picture p23: CAD file, 2026-10-30]
hardware/3d-models/rover-v3/fusion/RoverFusion/assets/hardware/tracker_sensors.step
34.0 x 6.00 x 3.00 mm
