westondunn/elegoo-smart-car-v4/hardware/3d-models/rover-v3/fusion/RoverFusion/assets/printed/uno_standoff_03.step

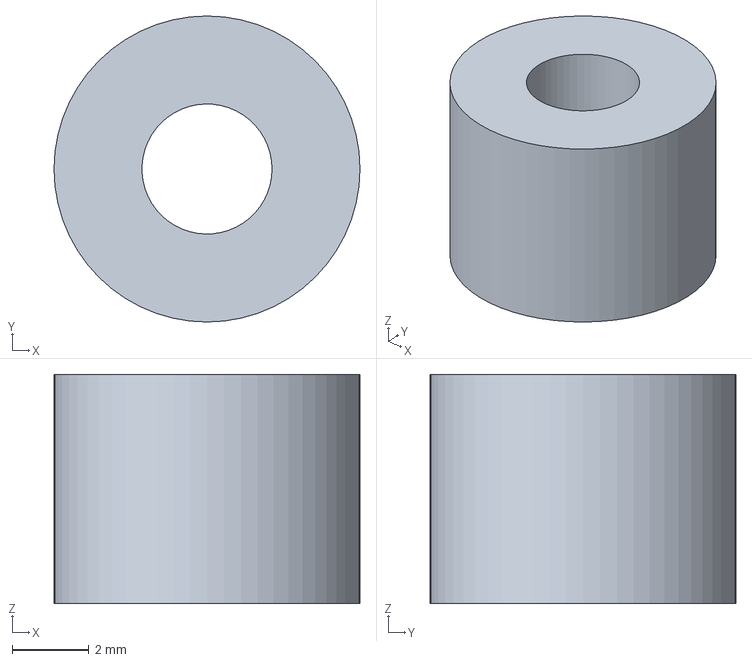
[picture p24: CAD file, 2026-10-30]
hardware/3d-models/rover-v3/fusion/RoverFusion/assets/printed/uno_standoff_03.step
8.00 x 8.00 x 6.00 mm
