westondunn/elegoo-smart-car-v4/hardware/3d-models/rover-v3/fusion/RoverFusion/assets/hardware/motor_can_front_right.step

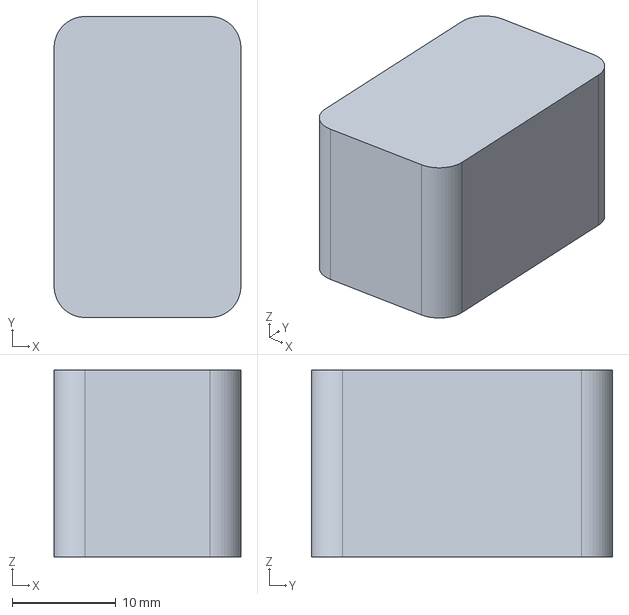
[picture p27: CAD file, 2026-10-30]
hardware/3d-models/rover-v3/fusion/RoverFusion/assets/hardware/motor_can_front_right.step
18.0 x 29.0 x 18.0 mm
