westondunn/elegoo-smart-car-v4/hardware/3d-models/rover-v3/fusion/RoverFusion/assets/hardware/tire_rear_right.step

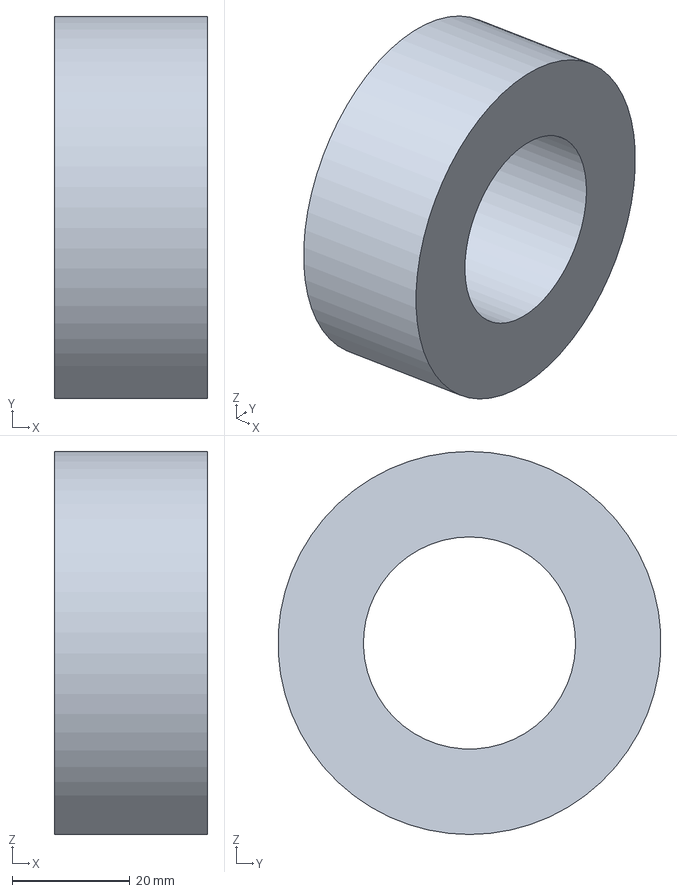
[picture p28: CAD file, 2026-10-30]
hardware/3d-models/rover-v3/fusion/RoverFusion/assets/hardware/tire_rear_right.step
26.0 x 64.9 x 65.0 mm
