westondunn/elegoo-smart-car-v4/hardware/3d-models/rover-v3/fusion/RoverFusion/assets/hardware/ultrasonic_board.step

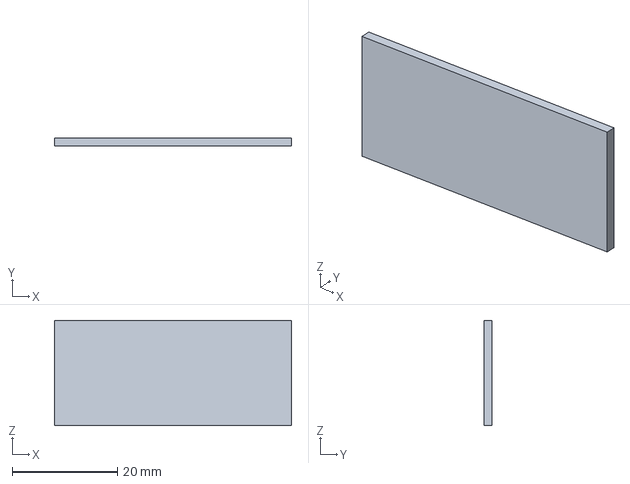
[picture p31: CAD file, 2026-10-30]
hardware/3d-models/rover-v3/fusion/RoverFusion/assets/hardware/ultrasonic_board.step
45.0 x 1.60 x 20.0 mm
