westondunn/elegoo-smart-car-v4/hardware/3d-models/rover-v3/fusion/RoverFusion/assets/hardware/shield_connectors.step

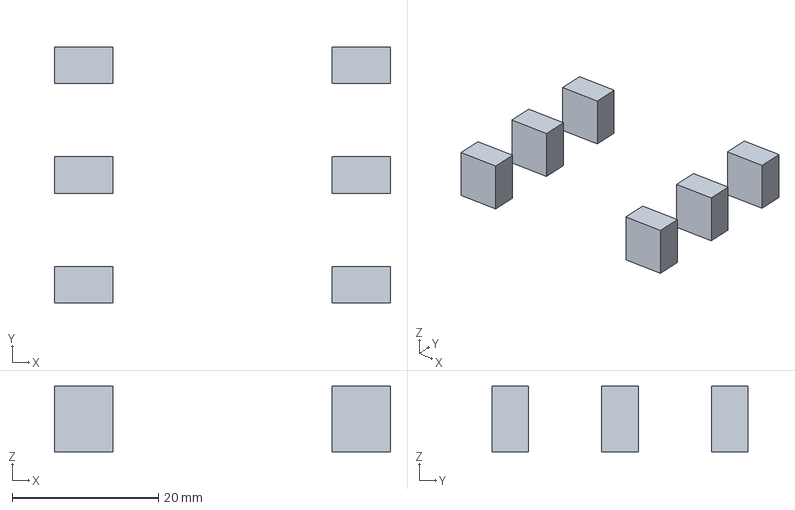
[picture p32: CAD file, 2026-10-30]
hardware/3d-models/rover-v3/fusion/RoverFusion/assets/hardware/shield_connectors.step
46.0 x 35.0 x 9.00 mm
