westondunn/elegoo-smart-car-v4/(list of files, cad)

Other CAD files:
hardware/3d-models/rover-v3/print/fit_checks/c1_motor_fit_x1c_pla.3mf
hardware/3d-models/rover-v3/fusion/RoverFusion/assets/printed/bank_rail_right.step
hardware/3d-models/rover-v3/fusion/RoverFusion/assets/printed/support_post_04.step
hardware/3d-models/rover-v3/fusion/RoverFusion/assets/printed/support_post_03.step
hardware/3d-models/rover-v3/fusion/RoverFusion/assets/hardware/wheel_hub_front_right.step
hardware/3d-models/rover-v3/fusion/RoverFusion/assets/printed/support_post_02.step
hardware/3d-models/rover-v3/fusion/RoverFusion/assets/hardware/motor_rear_left.step
hardware/3d-models/rover-v3/fusion/RoverFusion/assets/printed/tracker_spacer_02.step
hardware/3d-models/rover-v3/fusion/RoverFusion/assets/printed/pi_standoff_04.step
hardware/3d-models/rover-v3/fusion/RoverFusion/assets/printed/pi_standoff_02.step
hardware/3d-models/rover-v3/fusion/RoverFusion/assets/hardware/shaft_rear_left.step
hardware/3d-models/rover-v3/fusion/RoverFusion/assets/printed/pi_standoff_03.step
hardware/3d-models/rover-v3/fusion/RoverFusion/assets/hardware/block_rear_left.step
hardware/3d-models/rover-v3/fusion/RoverFusion/assets/printed/uno_standoff_02.step
hardware/3d-models/rover-v3/fusion/RoverFusion/assets/printed/support_post_05.step
hardware/3d-models/rover-v3/fusion/RoverFusion/assets/printed/tracker_spacer_04.step
hardware/3d-models/rover-v3/fusion/RoverFusion/assets/printed/uno_standoff_01.step
hardware/3d-models/rover-v3/fusion/RoverFusion/assets/hardware/tire_rear_left.step
hardware/3d-models/rover-v3/fusion/RoverFusion/assets/printed/tracker_spacer_03.step
hardware/3d-models/rover-v3/fusion/RoverFusion/assets/printed/support_post_01.step
hardware/3d-models/rover-v3/fusion/RoverFusion/assets/hardware/shaft_front_left.step
hardware/3d-models/rover-v3/fusion/RoverFusion/assets/hardware/motor_can_front_left.step
hardware/3d-models/rover-v3/fusion/RoverFusion/assets/hardware/wheel_hub_rear_right.step
hardware/3d-models/rover-v3/fusion/RoverFusion/assets/hardware/shaft_rear_right.step
hardware/3d-models/rover-v3/fusion/RoverFusion/assets/hardware/motor_can_rear_left.step
hardware/3d-models/rover-v3/fusion/RoverFusion/assets/hardware/block_front_right.step
hardware/3d-models/rover-v3/fusion/RoverFusion/assets/hardware/tire_front_right.step
hardware/3d-models/rover-v3/fusion/RoverFusion/assets/hardware/motor_front_right.step
hardware/3d-models/rover-v3/fusion/RoverFusion/assets/hardware/block_front_left.step
hardware/3d-models/rover-v3/fusion/RoverFusion/assets/hardware/motor_front_left.step
hardware/3d-models/rover-v3/fusion/RoverFusion/assets/hardware/motor_can_rear_right.step
hardware/3d-models/rover-v3/fusion/RoverFusion/assets/hardware/wheel_hub_front_left.step
hardware/3d-models/rover-v3/fusion/RoverFusion/assets/hardware/tire_front_left.step
hardware/3d-models/rover-v3/cad/complete_assembly.f3d
hardware/3d-models/rover-v3/print/fit_checks/c2_washer_gauge_x1c_pla.3mf
