westondunn/elegoo-smart-car-v4/hardware/3d-models/rover-v3/preview/full_assembly.png

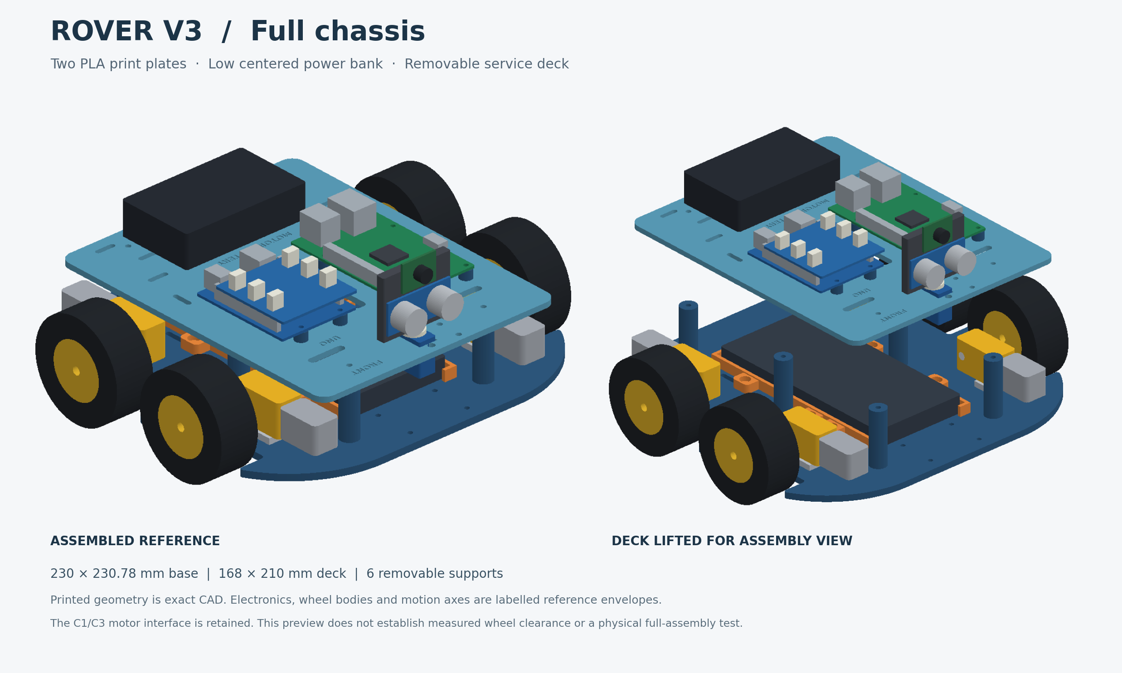
hardware/3d-models/rover-v3/preview/full_assembly.png
