westondunn/elegoo-smart-car-v4/(commit log)

2026-10-12 Add CI workflow and firmware report script for Arduino compilation
2026-10-12 Fix CI compile step so build failures reach the report
    The default GitHub Actions bash shell runs with -e, so a non-zero
    arduino-cli exit aborted the step before the exit code was recorded and
    the report step was skipped, leaving no compiler output in the log.
    Capture the exit code with || instead, skip the base-commit build when
    HEAD does not compile, and let the report step fail the job with the
    error in the job summary.
2026-10-30 Correct README facts and add community hardware and licensing note
    Fix statements in both READMEs that do not match the repository: the main
    sketch is ELEGOO-Smart-Robot-Car-Kit-V4.0-New.ino (not SmartRobotCarV4.0.ino),
    there is no addLibrary/ folder or README.txt, and the serial examples attach
    T to the untimed commands. In ApplicationFunctionSet.cpp N=2 and N=7 are the
    timed variants that read T; N=3 and N=8 ignore it. The examples now use N=2
    and N=7 and the command table says which variant is timed.
    Add a short section pointing to the community fork that maintains
    3D-printed chassis designs built around the kit hardware, and state the
    licensing situation: no license file ships here, ELE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
2026-10-30 Import Rover V3 model package verbatim with provenance manifest
    Copy the maintainer's current rover CAD package (Rover V3) into
    hardware/3d-models byte-for-byte: the Fusion Personal package (RoverFusion
    builder 3.0.1, RoverMotion 1.0.1, CadQuery sources, electrical reference
    tables, project documentation and validation records), the native F3D build
    output, the complete-assembly STEP, the two-plate X1C print project and the
    fit-check jobs.
    Byte-identical loose duplicates are recorded instead of copied. Third-party
    ELEGOO schematic PDFs are not redistributed (pinned source and retrieval
    steps in reference/README.md). Generated caches and Fusion-created editor
    files are excluded. The seven ea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
    [Fusion_Feature_Map.csv, HARNESS_FUNCTIONAL_REFERENCE.csv, OEM_REVISION_PIN_REFERENCE.csv, Rover_C3_Recessed_Mount_Features_X1C_PLA.3mf, Rover_C3_Recessed_Mount_Features_X1C_PLA_alt1.3mf, Rover_Fit_Batch_X1C_PLA.3mf, Rover_V3_BOM.csv, Rover_V3_C1_Motor_Fit.step]
2026-10-30 Normalise Rover V3 layout, keep kit-only hardware references, add docs
    Second, reviewable change on top of the verbatim import, made at the
    maintainer's request.
    Layout: hardware/3d-models/rover-v3/<category>/<snake_case_name> (cad, print,
    source, fusion, docs, verification, preview, reference). Fusion script
    folders and module names are kept because Fusion loads them by name. Old
    paths and names are recorded per asset in manifest.json.
    Kit-only hardware: the Raspberry Pi (board, connectors, processor) and the
    flat power bank reference envelopes are removed from the RoverFusion asset
    folder, assembly_manifest.json, the RoverMotion part catalog/motion plan and
    the offline tests (64 -> 60 co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
    [Fusion_Feature_Map.csv, Rover_V3_BOM.csv, bank_rail_left.step, bank_rail_right.step, base.step, block_front_left.step, block_front_right.step, block_rear_left.step]
